micahpinto/asynchronous-fifo/results/async_binary_wave.png

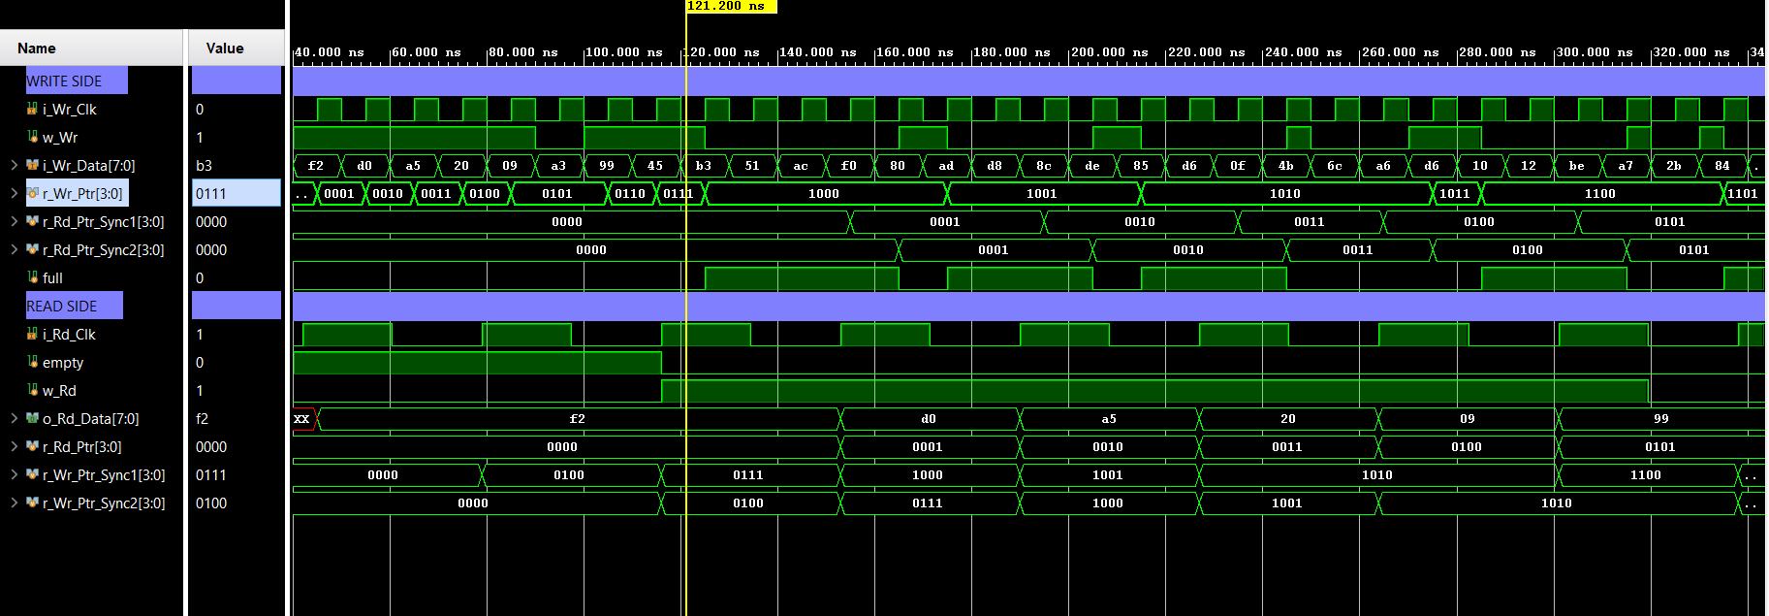
results/async_binary_wave.png
