micahpinto/asynchronous-fifo/results/async_clock_interaction_after.png

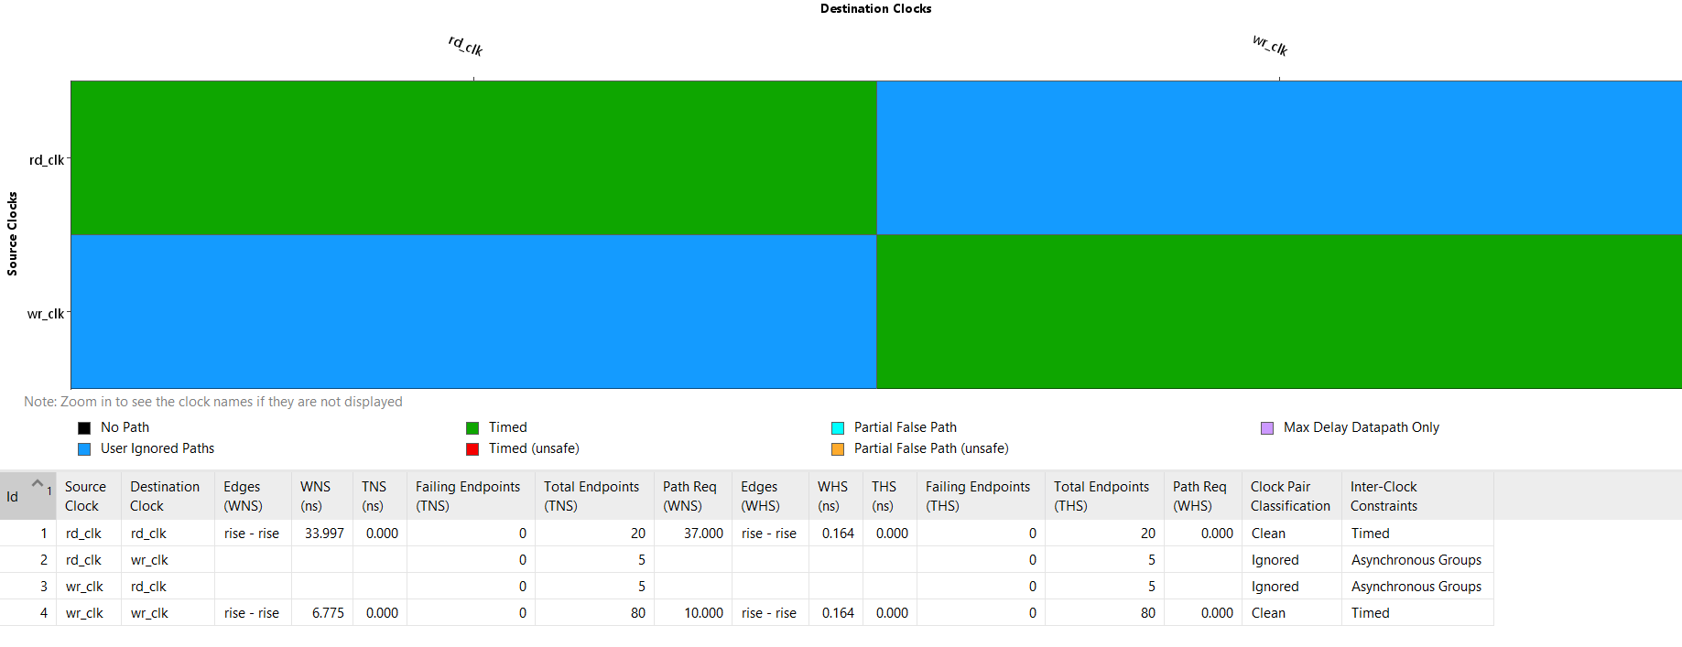
results/async_clock_interaction_after.png
