micahpinto/asynchronous-fifo/results/async_clock_interaction_before.png

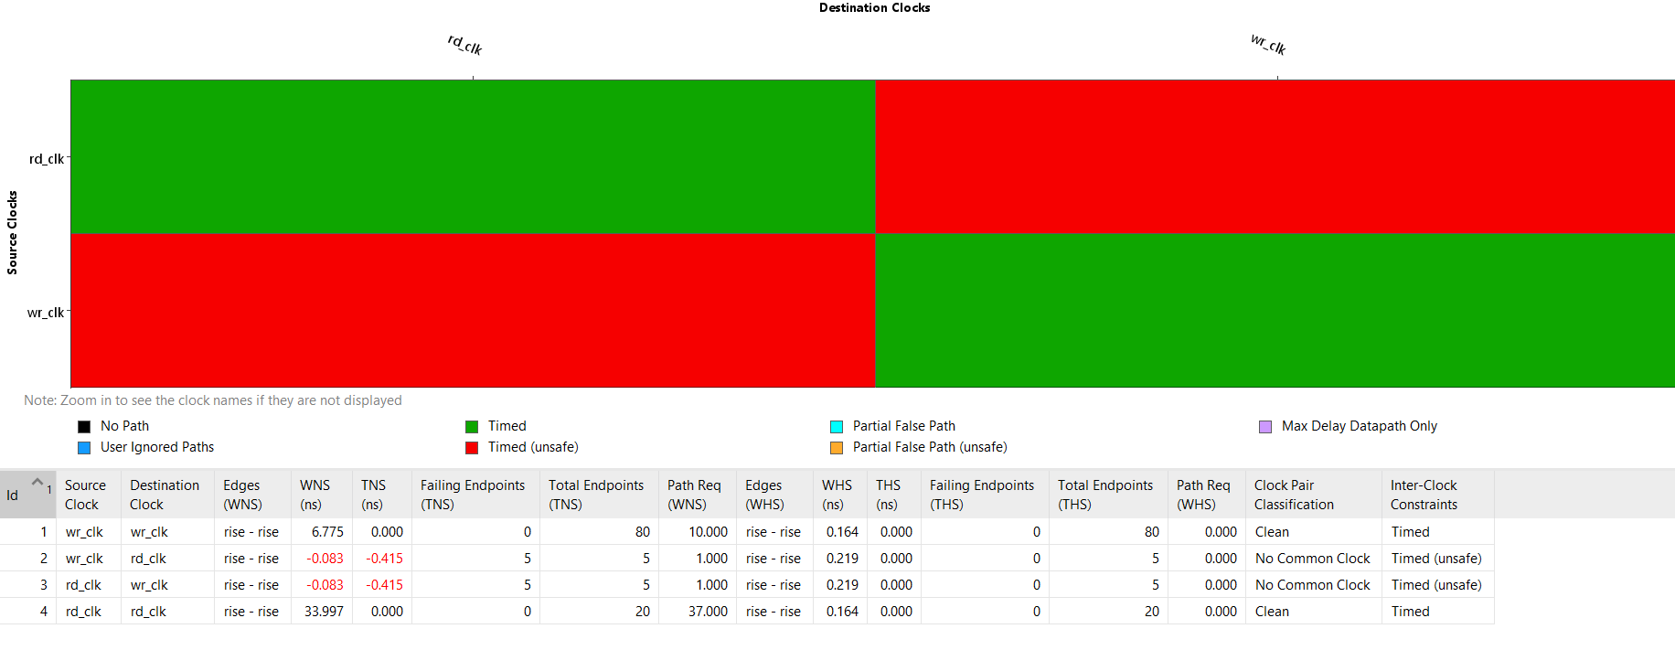
results/async_clock_interaction_before.png
