micahpinto/asynchronous-fifo/results/async_hw_10min.jpg

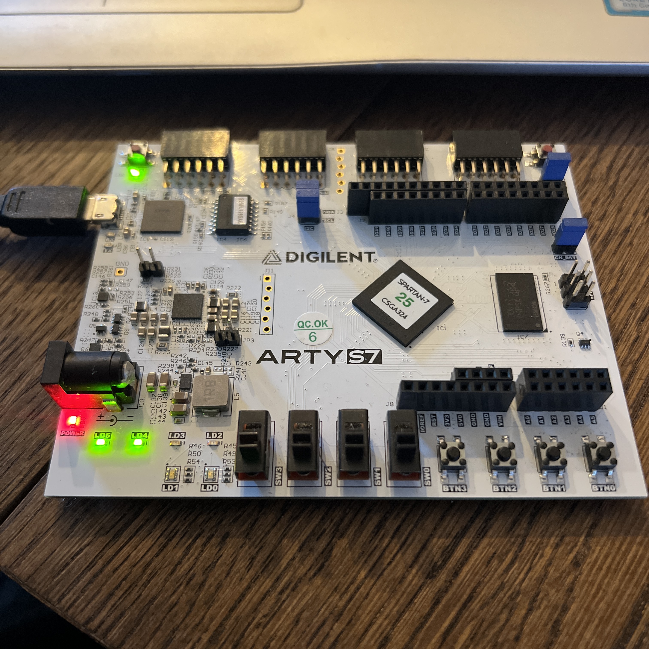
results/async_hw_10min.jpg
